Lunarequest/foxboard/#keyboard-layout.dxf

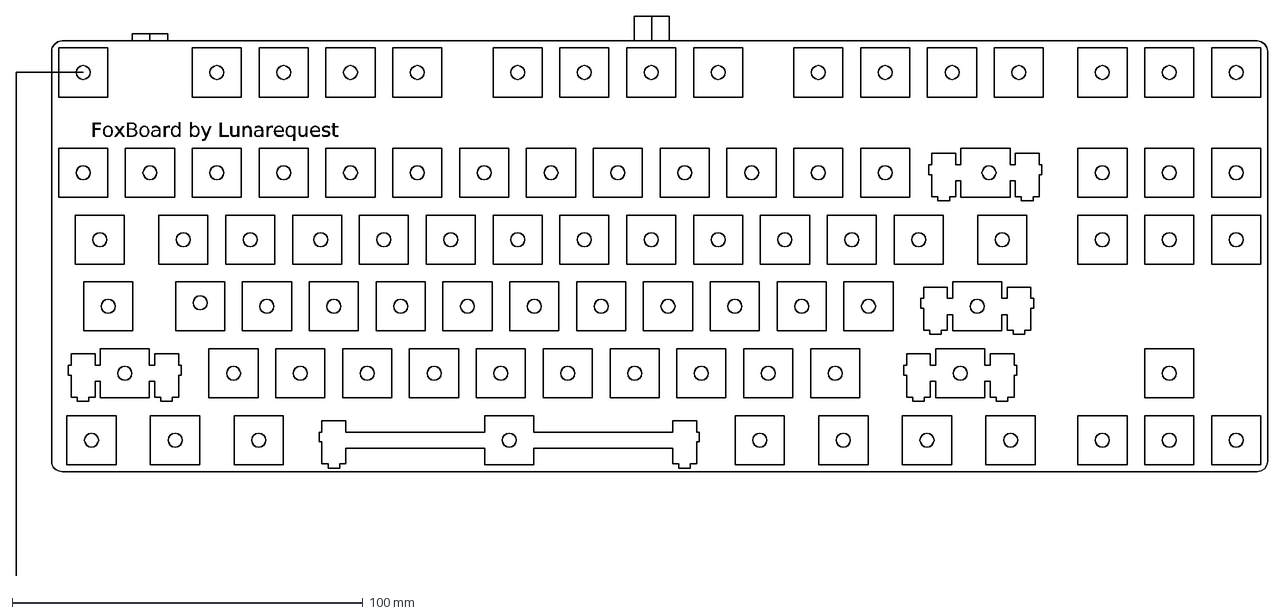
[picture p1: CAD file, 2024-01-16]
#keyboard-layout.dxf
FoxBoard by Lunarequest
