Lunarequest/foxboard/(list of files, cad)

Other CAD files:
keyboard-layout.dxf
