Lunarequest/foxboard/kicad/foxboard/foxboard.pdf

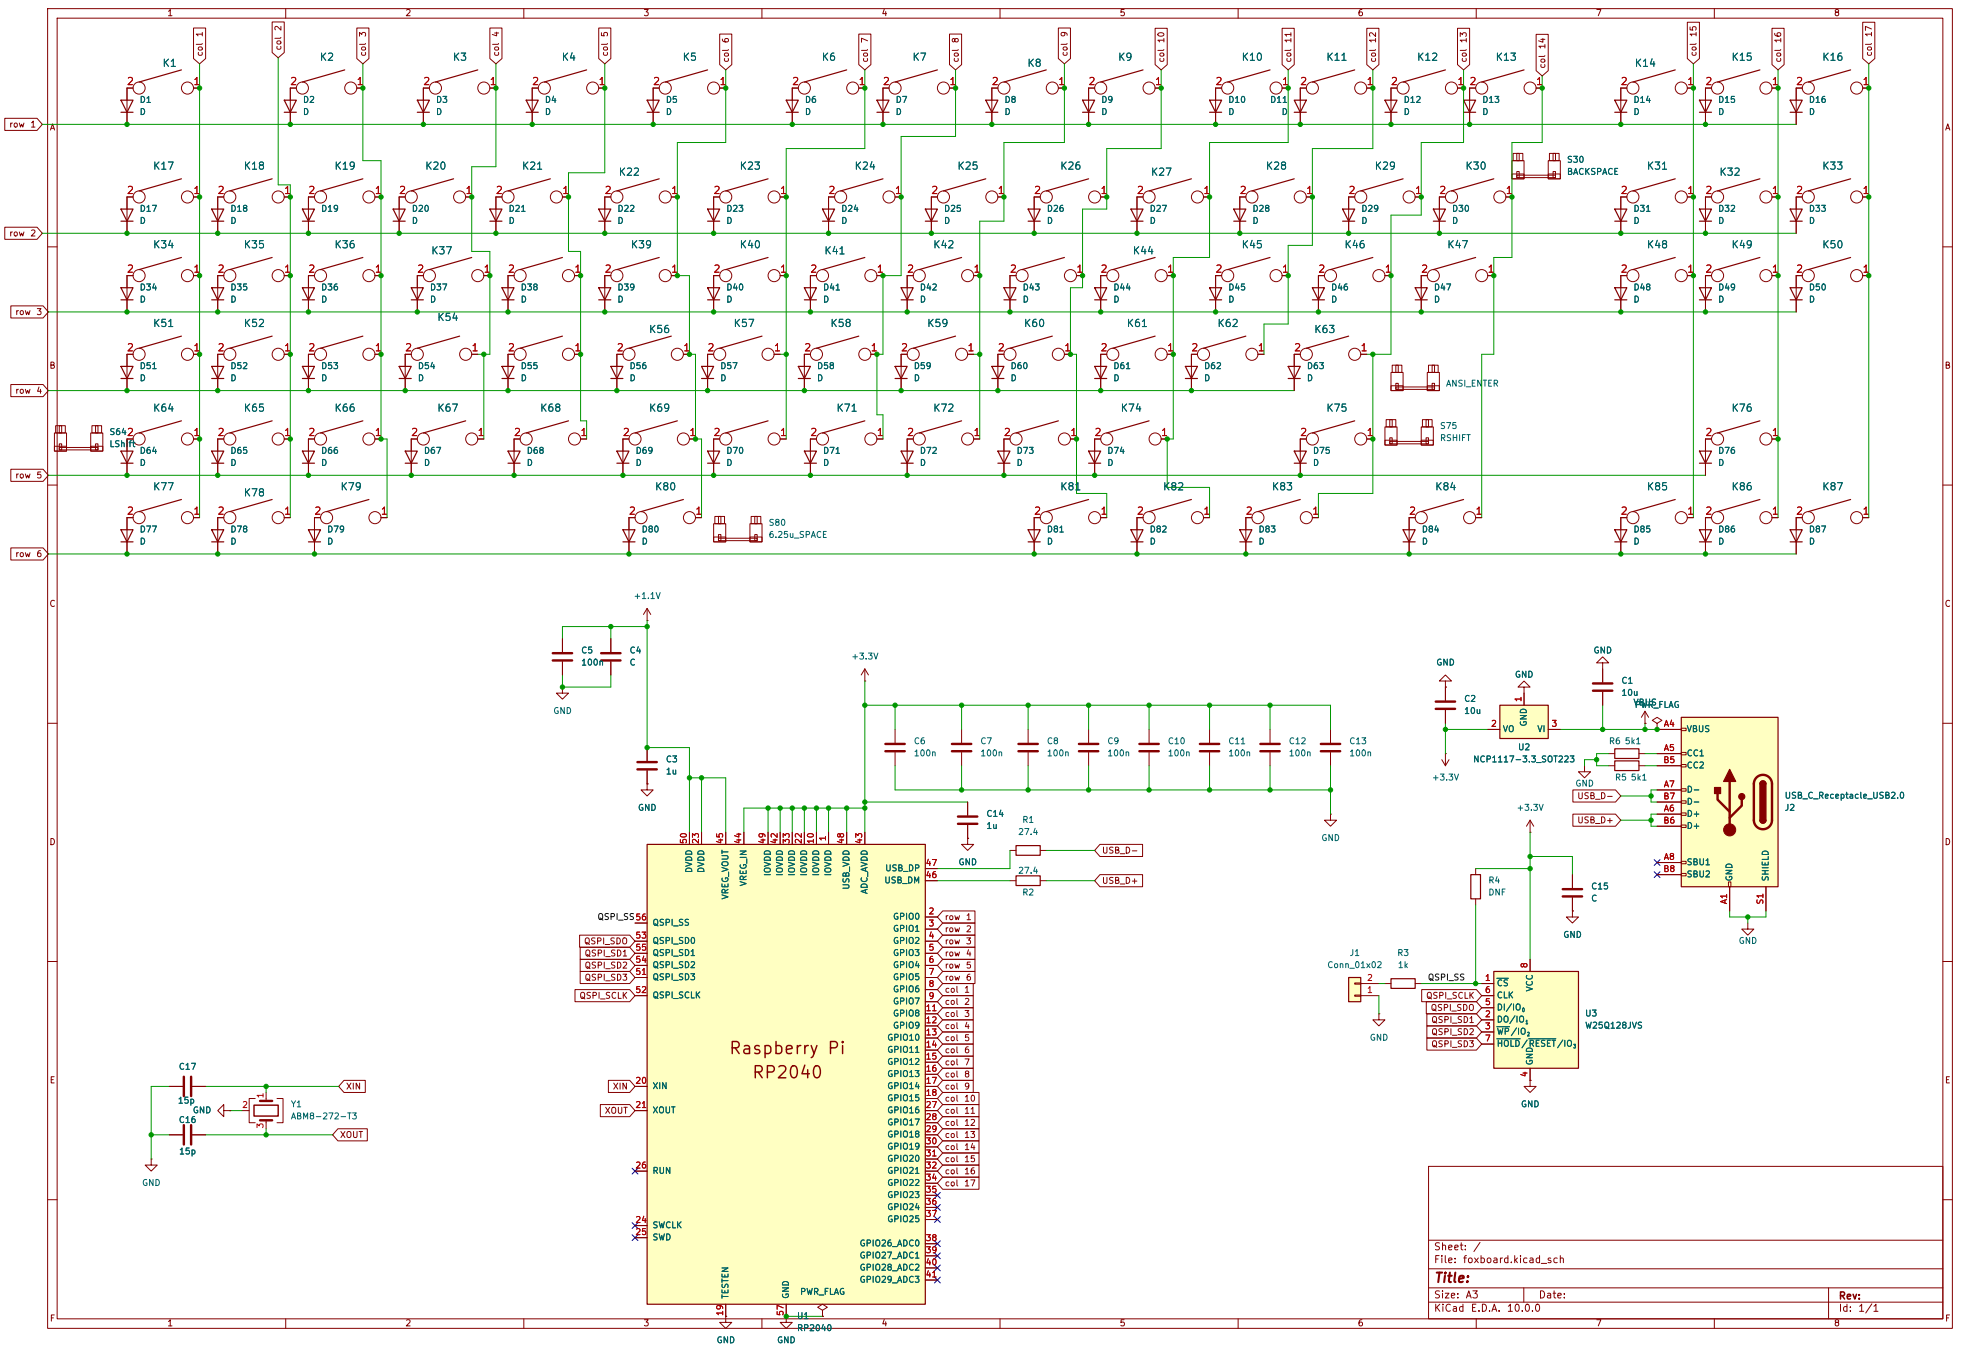
[picture p2: page 1]

4 DI/IO0 5 CLK 6 HOLD/RESET/IO3 7 VCC

Size: A3 | Rev: | F Date:
KiCad E.D.A. 10.0.0 | Id: 1/1
