Lunarequest/foxboard/kicad/foxboard/foxboard.kicad_pcb

## KiCad design kicad/foxboard/foxboard.kicad_pcb (2026-08-29)

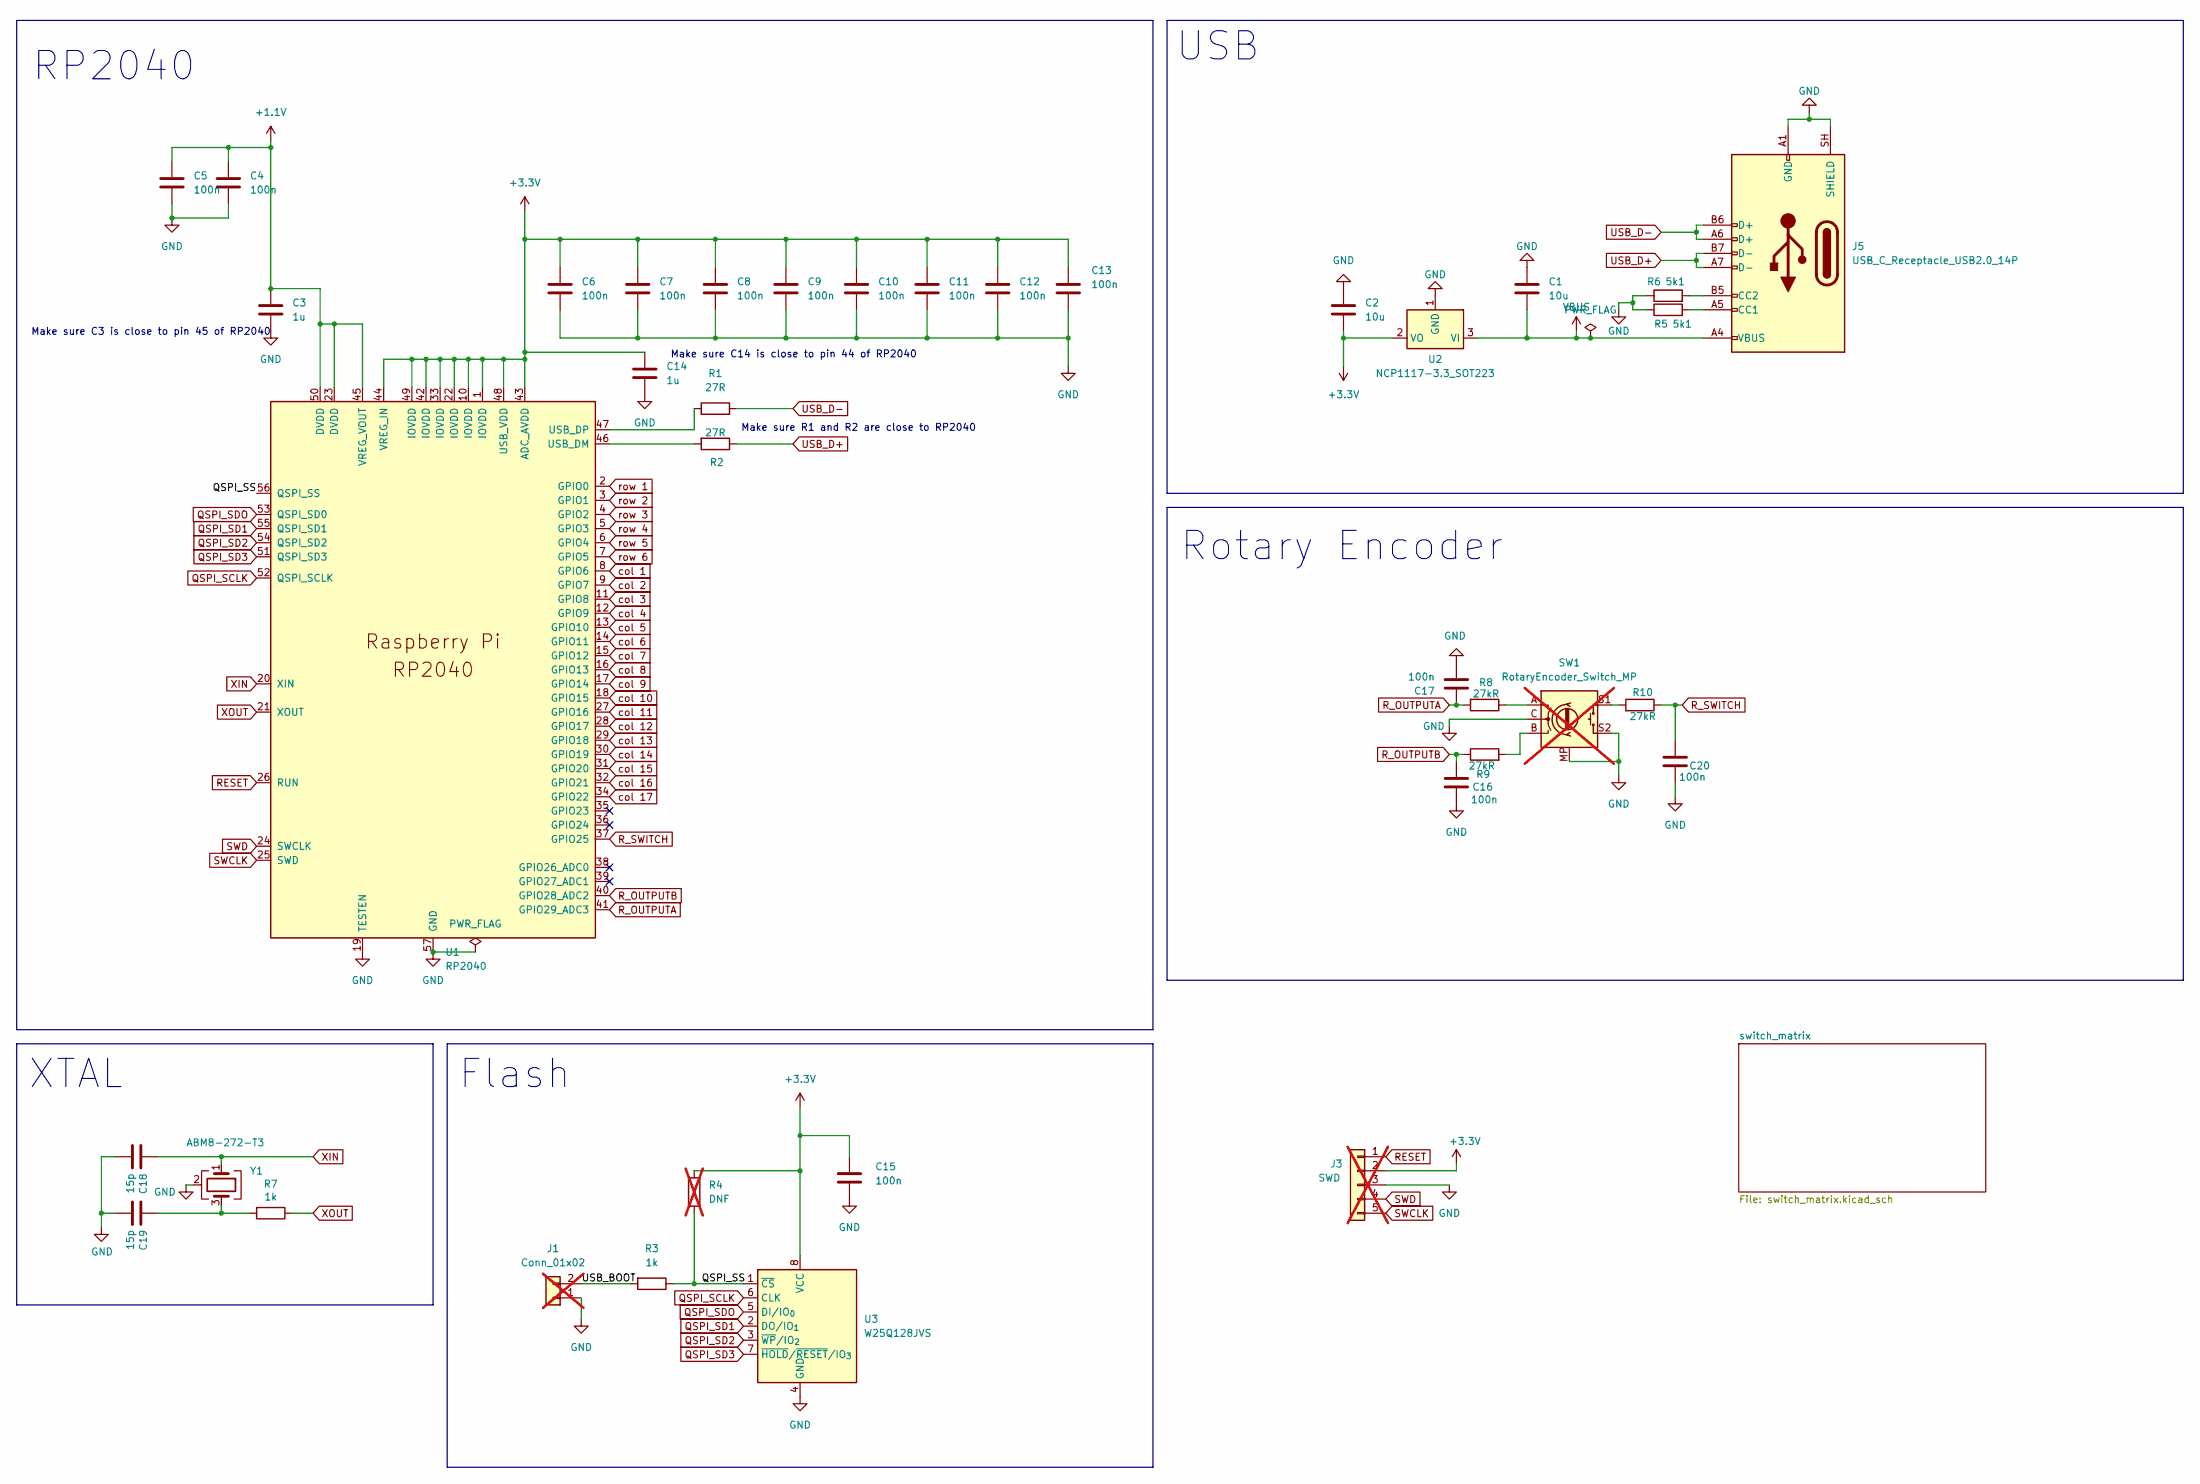
[picture p3: schematic foxboard.kicad_sch]

Parts:
C1, C2: 10u; C_0402_1005Metric_Pad0.74x0.62mm_HandSolder; MPN CL05A106MP5NUNC; LCSC C315248
C3, C14: 1u; C_0402_1005Metric_Pad0.74x0.62mm_HandSolder; MPN CL05A105KO5NNNC; LCSC C29266
C4, C5, C6, C7, C8, C9, C10, C11, C12, C13, C15, C16, C17, C20: 100n; C_0402_1005Metric_Pad0.74x0.62mm_HandSolder; MPN CL05B104KP5VPNC; LCSC C16193311
C18, C19: 15p; C_0402_1005Metric; MPN CL05C150JB5NNNC; LCSC C86285
J1: Conn_01x02; PinHeader_1x02_P2.54mm_Vertical; not fitted
J3: SWD; PinSocket_1x05_P2.54mm_Vertical; not fitted
J5: USB_C_Receptacle_USB2.0_14P; USB_C_Receptacle_HRO_TYPE-C-31-M-12; MPN TYPE-C-31-M-12; LCSC C165948
R1, R2: 27R; R_0402_1005Metric_Pad0.72x0.64mm_HandSolder; MPN 0402WGF1001TCE; LCSC C11702
R3, R7: 1k; R_0402_1005Metric_Pad0.72x0.64mm_HandSolder; MPN UNI-ROYAL TC0225B1001TCC; LCSC C2989674
R4: DNF; R_0402_1005Metric_Pad0.72x0.64mm_HandSolder; not fitted
R5, R6: 5k1; R_0402_1005Metric_Pad0.72x0.64mm_HandSolder; MPN 0402WGF5101TCE; LCSC C25905
R8, R9, R10: 27kR; R_0402_1005Metric_Pad0.72x0.64mm_HandSolder; MPN CRCW040227R0JNED
SW1: RotaryEncoder_Switch_MP; RotaryEncoder_Bourns_Horizontal_PEC12R-2x17F-Sxxxx; not fitted
U1: RP2040; RP2040-QFN-56; MPN RP2040; LCSC C2040
U2: NCP1117-3.3_SOT223; SOT-223-3_TabPin2; MPN NCP1117STAT3G; LCSC C20546
U3: W25Q128JVS; SOIC-8_5.3x5.3mm_P1.27mm; MPN W25Q128JVSIQ; LCSC C97521
Y1: ABM8-272-T3; Crystal_SMD_3225-4Pin_3.2x2.5mm; MPN XC32M4-12.000-F10NNFT; LCSC C2842186

Connections:
+1.1V: C3.1, C4.1, C5.1, U1.23 (DVDD), U1.45 (VREG_VOUT), U1.50 (DVDD)
+3.3V: C2.2, C6.1, C7.1, C8.1, C9.1, C10.1, C11.1, C12.1, C13.1, C14.1, C15.1, J3.2, R4.1, U1.1 (IOVDD), U1.10 (IOVDD), U1.22 (IOVDD), U1.33 (IOVDD), U1.42 (IOVDD), U1.43 (ADC_AVDD), U1.44 (VREG_IN), U1.48 (USB_VDD), U1.49 (IOVDD), U2.2 (VO), U3.8 (VCC)
/QSPI_SS: R3.1, R4.2, U1.56 (QSPI_SS), U3.1 (~CS)
/USB_BOOT: J1.2, R3.2
GND: C1.2, C2.1, C3.2, C4.2, C5.2, C6.2, C7.2, C8.2, C9.2, C10.2, C11.2, C12.2, C13.2, C14.2, C15.2, C16.2, C17.2, C18.2, C19.2, C20.2, J1.1, J3.3, J5.A1 (GND), J5.A12 (GND), J5.B1 (GND), J5.B12 (GND), J5.SH (SHIELD), R5.1, R6.1, SW1.C, SW1.MP, SW1.S2, U1.19 (TESTEN), U1.57 (GND), U2.1 (GND), U3.4 (GND), Y1.2 (G), Y1.4 (G)
unnamed: C19.1, R7.2, Y1.3
unnamed: J5.A5 (CC1), R5.2
unnamed: J5.B5 (CC2), R6.2
unnamed: R8.1, SW1.A
unnamed: R9.2, SW1.B
unnamed: R10.2, SW1.S1
unnamed: R2.2, U1.46 (USB_DM)
unnamed: R1.1, U1.47 (USB_DP)
QSPI_SCLK: U1.52 (QSPI_SCLK), U3.6 (CLK)
QSPI_SD1: U1.55 (QSPI_SD1), U3.2 (DO/IO_{1})
QSPI_SD2: U1.54 (QSPI_SD2), U3.3 (~WP/IO_{2})
QSPI_SD3: U1.51 (QSPI_SD3), U3.7 (~HOLD/~RESET/IO_{3})
QSPI_SDO: U1.53 (QSPI_SD0), U3.5 (DI/IO_{0})
RESET: J3.1, U1.26 (RUN)
R_OUTPUTA: C17.1, R8.2, U1.41 (GPIO29_ADC3)
R_OUTPUTB: C16.1, R9.1, U1.40 (GPIO28_ADC2)
R_SWITCH: C20.1, R10.1, U1.37 (GPIO25)
SWCLK: J3.5, U1.25 (SWD)
SWD: J3.4, U1.24 (SWCLK)
USB_D+: J5.A7 (D-), J5.B7 (D-), R2.1
USB_D-: J5.A6 (D+), J5.B6 (D+), R1.2
VBUS: C1.1, J5.A4 (VBUS), J5.A9 (VBUS), J5.B4 (VBUS), J5.B9 (VBUS), U2.3 (VI)
XIN: C18.1, U1.20 (XIN), Y1.1
XOUT: R7.1, U1.21 (XOUT)
col 1: U1.8 (GPIO6); also elsewhere on the board
col 2: U1.9 (GPIO7); also elsewhere on the board
col 3: U1.11 (GPIO8); also elsewhere on the board
col 4: U1.12 (GPIO9); also elsewhere on the board
col 5: U1.13 (GPIO10); also elsewhere on the board
col 6: U1.14 (GPIO11); also elsewhere on the board
col 7: U1.15 (GPIO12); also elsewhere on the board
col 8: U1.16 (GPIO13); also elsewhere on the board
col 9: U1.17 (GPIO14); also elsewhere on the board
col 10: U1.18 (GPIO15); also elsewhere on the board
col 11: U1.27 (GPIO16); also elsewhere on the board
col 12: U1.28 (GPIO17); also elsewhere on the board
col 13: U1.29 (GPIO18); also elsewhere on the board
col 14: U1.30 (GPIO19); also elsewhere on the board
col 15: U1.31 (GPIO20); also elsewhere on the board
col 16: U1.32 (GPIO21); also elsewhere on the board
col 17: U1.34 (GPIO22); also elsewhere on the board
row 1: U1.2 (GPIO0); also elsewhere on the board
row 2: U1.3 (GPIO1); also elsewhere on the board
row 3: U1.4 (GPIO2); also elsewhere on the board
row 4: U1.5 (GPIO3); also elsewhere on the board
row 5: U1.6 (GPIO4); also elsewhere on the board
row 6: U1.7 (GPIO5); also elsewhere on the board

Notes on the sheet:
USB
RP2040
Make sure C14 is close to pin 44 of RP2040
XTAL
Rotary Encoder
Make sure C3 is close to pin 45 of RP2040
Make sure R1 and R2 are close to RP2040
Flash

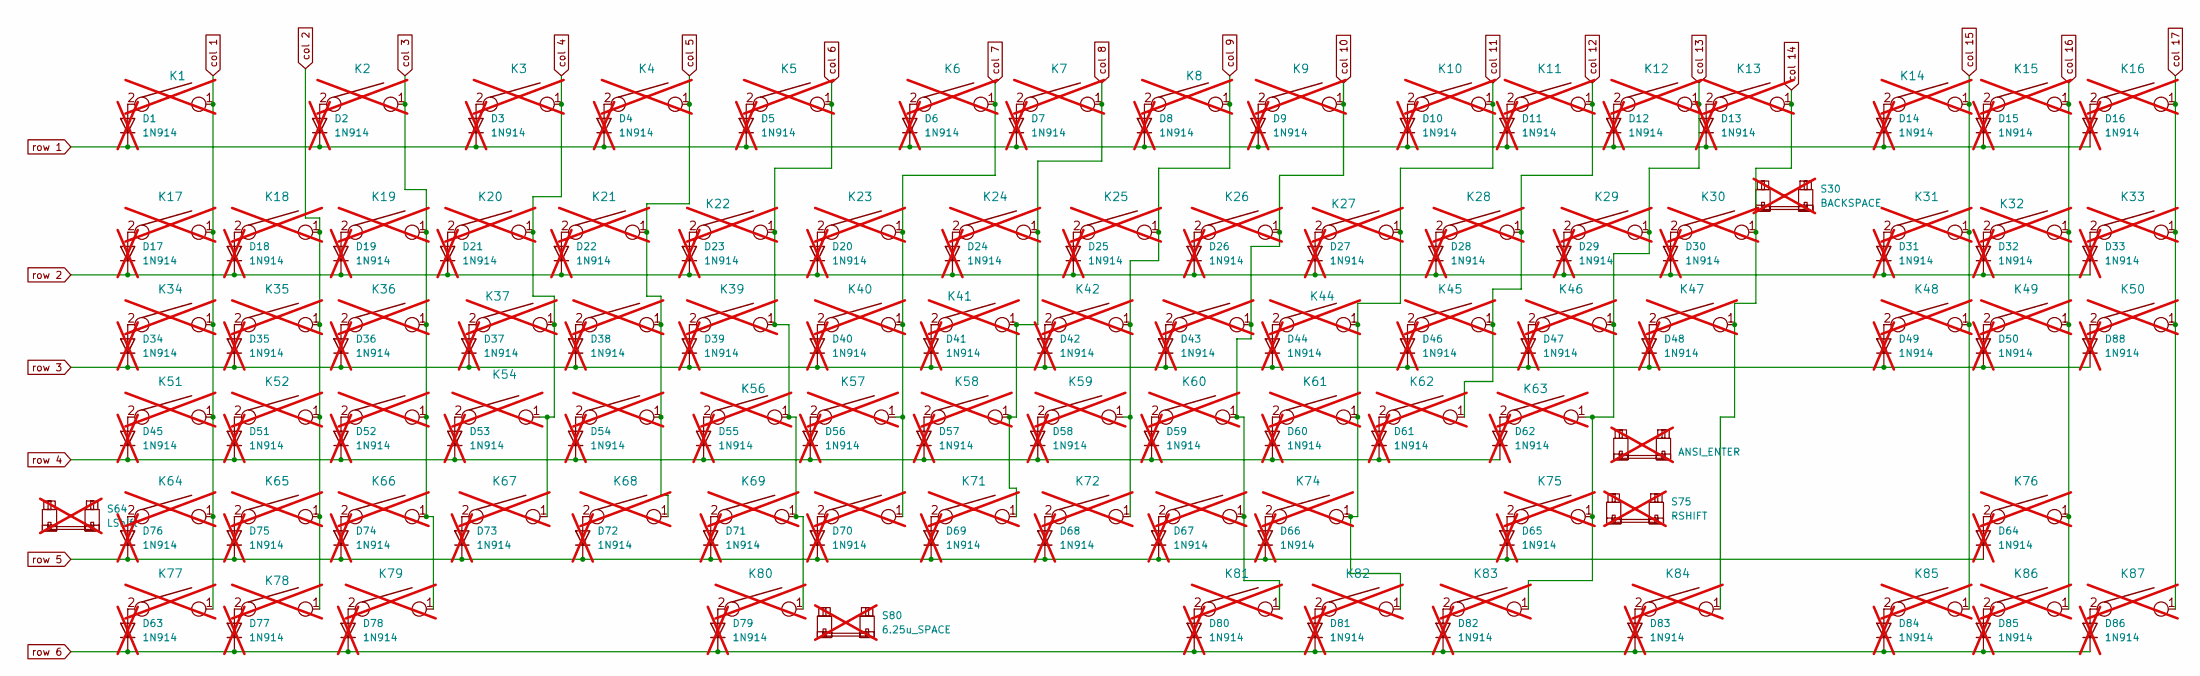
[picture p4: schematic switch_matrix.kicad_sch]

Parts:
D1, D2, D3, D4, D5, D6, D7, D8, D9, D10, D11, D12, D13, D14, D15, D16, D17, D18, D19, D20, D21, D22, D23, D24, D25, D26, D27, D28, D29, D30, D31, D32, D33, D34, D35, D36, D37, D38, D39, D40, D41, D42, D43, D44, D45, D46, D47, D48, D49, D50, D51, D52, D53, D54, D55, D56, D57, D58, D59, D60, D61, D62, D63, D64, D65, D66, D67, D68, D69, D70, D71, D72, D73, D74, D75, D76, D77, D78, D79, D80, D81, D82, D83, D84, D85, D86, D88: 1N914; D_DO-35_SOD27_P7.62mm_Horizontal; MPN 1N914TAP; LCSC C17693320; not fitted
K1, K2, K3, K4, K5, K6, K7, K8, K10, K11, K12, K13, K14, K16, K17, K18, K19, K20, K21, K22, K23, K24, K25, K26, K27, K28, K29, K30, K31, K32, K33, K35, K36, K37, K38, K39, K40, K41, K42, K43, K44, K45, K46, K48, K49, K50, K52, K53, K54, K55, K56, K57, K58, K59, K60, K61, K62, K63, K64, K65, K66, K67, K68, K69, K70, K71, K72, K73, K74, K75, K76, K80, K84, K85, K86, K87: KEYSW; SW_MX_1u; not fitted
K9, K15, K77, K78, K79, K81, K82, K83: KEYSW; SW_MX_1.25u; not fitted
K34, K47: KEYSW; SW_MX_1.5u; not fitted
K51: KEYSW; SW_MX_1.75u; not fitted
S30: BACKSPACE; STAB_MX_2u; not fitted
S63: ANSI_ENTER; STAB_MX_2.25u; not fitted
S64: LShift; STAB_MX_2.25u; not fitted
S75: RSHIFT; STAB_MX_P_2.75u; not fitted
S80: 6.25u_SPACE; STAB_MX_P_6.25u; not fitted

Connections:
unnamed: D1.2 (A), K1.2
unnamed: D2.2 (A), K2.2
unnamed: D3.2 (A), K3.2
unnamed: D4.2 (A), K4.2
unnamed: D5.2 (A), K5.2
unnamed: D6.2 (A), K6.2
unnamed: D7.2 (A), K7.2
unnamed: D8.2 (A), K8.2
unnamed: D9.2 (A), K9.2
unnamed: D10.2 (A), K10.2
unnamed: D11.2 (A), K11.2
unnamed: D12.2 (A), K12.2
unnamed: D13.2 (A), K13.2
unnamed: D14.2 (A), K14.2
unnamed: D15.2 (A), K15.2
unnamed: D16.2 (A), K16.2
unnamed: D17.2 (A), K17.2
unnamed: D18.2 (A), K18.2
unnamed: D19.2 (A), K19.2
unnamed: D20.2 (A), K23.2
unnamed: D21.2 (A), K20.2
unnamed: D22.2 (A), K21.2
unnamed: D23.2 (A), K22.2
unnamed: D24.2 (A), K24.2
unnamed: D25.2 (A), K25.2
unnamed: D26.2 (A), K26.2
unnamed: D27.2 (A), K27.2
unnamed: D28.2 (A), K28.2
unnamed: D29.2 (A), K29.2
unnamed: D30.2 (A), K30.2
unnamed: D31.2 (A), K31.2
unnamed: D32.2 (A), K32.2
unnamed: D33.2 (A), K33.2
unnamed: D34.2 (A), K34.2
unnamed: D35.2 (A), K35.2
unnamed: D36.2 (A), K36.2
unnamed: D37.2 (A), K37.2
unnamed: D38.2 (A), K38.2
unnamed: D39.2 (A), K39.2
unnamed: D40.2 (A), K40.2
unnamed: D41.2 (A), K41.2
unnamed: D42.2 (A), K42.2
unnamed: D43.2 (A), K43.2
unnamed: D44.2 (A), K44.2
unnamed: D45.2 (A), K51.2
unnamed: D46.2 (A), K45.2
unnamed: D47.2 (A), K46.2
unnamed: D48.2 (A), K47.2
unnamed: D49.2 (A), K48.2
unnamed: D50.2 (A), K49.2
unnamed: D51.2 (A), K52.2
unnamed: D52.2 (A), K53.2
unnamed: D53.2 (A), K54.2
unnamed: D54.2 (A), K55.2
unnamed: D55.2 (A), K56.2
unnamed: D56.2 (A), K57.2
unnamed: D57.2 (A), K58.2
unnamed: D58.2 (A), K59.2
unnamed: D59.2 (A), K60.2
unnamed: D60.2 (A), K61.2
unnamed: D61.2 (A), K62.2
unnamed: D62.2 (A), K63.2
unnamed: D63.2 (A), K77.2
unnamed: D64.2 (A), K76.2
unnamed: D65.2 (A), K75.2
unnamed: D66.2 (A), K74.2
unnamed: D67.2 (A), K73.2
unnamed: D68.2 (A), K72.2
unnamed: D69.2 (A), K71.2
unnamed: D70.2 (A), K70.2
unnamed: D71.2 (A), K69.2
unnamed: D72.2 (A), K68.2
unnamed: D73.2 (A), K67.2
unnamed: D74.2 (A), K66.2
unnamed: D75.2 (A), K65.2
unnamed: D76.2 (A), K64.2
unnamed: D77.2 (A), K78.2
unnamed: D78.2 (A), K79.2
unnamed: D79.2 (A), K80.2
unnamed: D80.2 (A), K81.2
unnamed: D81.2 (A), K82.2
unnamed: D82.2 (A), K83.2
unnamed: D83.2 (A), K84.2
unnamed: D84.2 (A), K85.2
unnamed: D85.2 (A), K86.2
unnamed: D86.2 (A), K87.2
unnamed: D88.2 (A), K50.2
col 1: K1.1, K17.1, K34.1, K51.1, K64.1, K77.1; also elsewhere on the board
col 2: K18.1, K35.1, K52.1, K65.1, K78.1; also elsewhere on the board
col 3: K2.1, K19.1, K36.1, K53.1, K66.1, K79.1; also elsewhere on the board
col 4: K3.1, K20.1, K37.1, K54.1, K67.1; also elsewhere on the board
col 5: K4.1, K21.1, K38.1, K55.1, K68.1; also elsewhere on the board
col 6: K5.1, K22.1, K39.1, K56.1, K69.1, K80.1; also elsewhere on the board
col 7: K6.1, K23.1, K40.1, K57.1, K70.1; also elsewhere on the board
col 8: K7.1, K24.1, K41.1, K58.1, K71.1; also elsewhere on the board
col 9: K8.1, K25.1, K42.1, K59.1, K72.1; also elsewhere on the board
col 10: K9.1, K26.1, K43.1, K60.1, K73.1, K81.1; also elsewhere on the board
col 11: K10.1, K27.1, K44.1, K61.1, K74.1, K82.1; also elsewhere on the board
col 12: K11.1, K28.1, K45.1, K62.1; also elsewhere on the board
col 13: K12.1, K29.1, K46.1, K63.1, K75.1, K83.1; also elsewhere on the board
col 14: K13.1, K30.1, K47.1, K84.1; also elsewhere on the board
col 15: K14.1, K31.1, K48.1, K85.1; also elsewhere on the board
col 16: K15.1, K32.1, K49.1, K76.1, K86.1; also elsewhere on the board
col 17: K16.1, K33.1, K50.1, K87.1; also elsewhere on the board
row 1: D1.1 (K), D2.1 (K), D3.1 (K), D4.1 (K), D5.1 (K), D6.1 (K), D7.1 (K), D8.1 (K), D9.1 (K), D10.1 (K), D11.1 (K), D12.1 (K), D13.1 (K), D14.1 (K), D15.1 (K), D16.1 (K); also elsewhere on the board
row 2: D17.1 (K), D18.1 (K), D19.1 (K), D20.1 (K), D21.1 (K), D22.1 (K), D23.1 (K), D24.1 (K), D25.1 (K), D26.1 (K), D27.1 (K), D28.1 (K), D29.1 (K), D30.1 (K), D31.1 (K), D32.1 (K), D33.1 (K); also elsewhere on the board
row 3: D34.1 (K), D35.1 (K), D36.1 (K), D37.1 (K), D38.1 (K), D39.1 (K), D40.1 (K), D41.1 (K), D42.1 (K), D43.1 (K), D44.1 (K), D46.1 (K), D47.1 (K), D48.1 (K), D49.1 (K), D50.1 (K), D88.1 (K); also elsewhere on the board
row 4: D45.1 (K), D51.1 (K), D52.1 (K), D53.1 (K), D54.1 (K), D55.1 (K), D56.1 (K), D57.1 (K), D58.1 (K), D59.1 (K), D60.1 (K), D61.1 (K), D62.1 (K); also elsewhere on the board
row 5: D64.1 (K), D65.1 (K), D66.1 (K), D67.1 (K), D68.1 (K), D69.1 (K), D70.1 (K), D71.1 (K), D72.1 (K), D73.1 (K), D74.1 (K), D75.1 (K), D76.1 (K); also elsewhere on the board
row 6: D63.1 (K), D77.1 (K), D78.1 (K), D79.1 (K), D80.1 (K), D81.1 (K), D82.1 (K), D83.1 (K), D84.1 (K), D85.1 (K), D86.1 (K); also elsewhere on the board

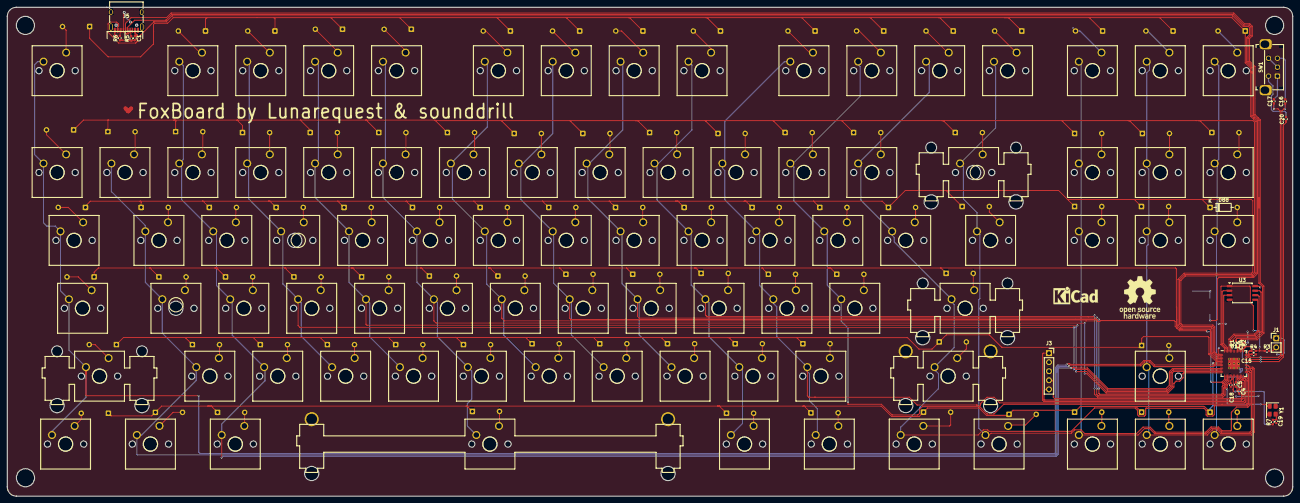
[picture p5: board foxboard.kicad_pcb from above]

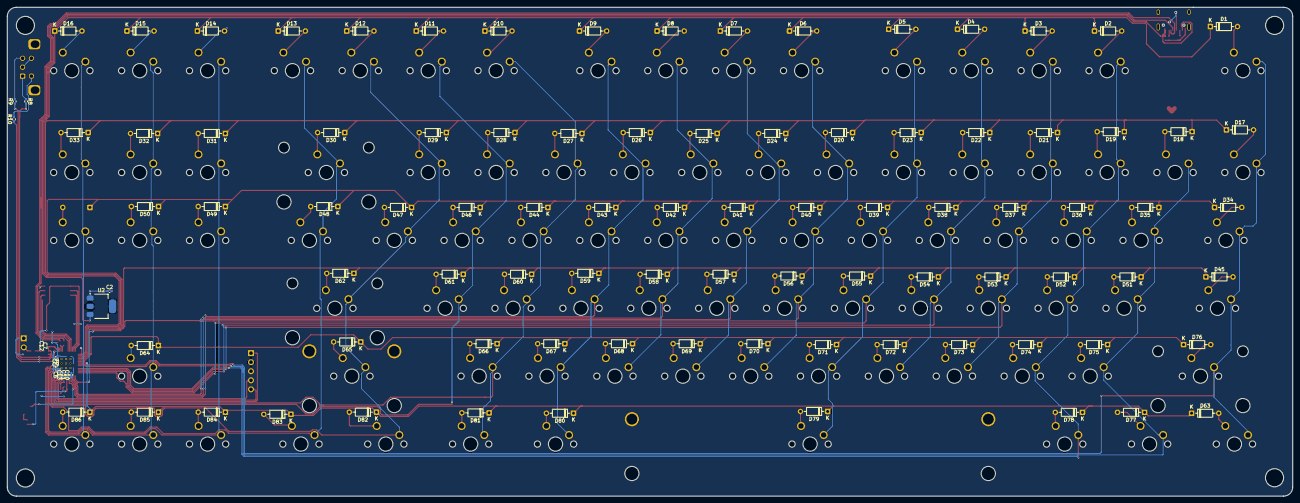
[picture p6: board foxboard.kicad_pcb from below]

Board: 2 copper layers, 360.7 x 137.2 mm, 217 parts (99 on the bottom side), 139 nets.
