Lunarequest/foxboard/(commit log)

2023-06-28 wip foxboard
    [foxboard.kicad_pcb, foxboard.kicad_sch, keyboard-layout.dxf]
2024-01-16 move teensy and stuff
    [foxboard.kicad_pcb]
2024-01-16 add keyswitch and change some footprints
    [foxboard.kicad_pcb]
2024-01-16 update layout
    [foxboard.kicad_pcb, foxboard.kicad_sch]
2024-01-16 update some footprints and move most diodes into place
    [foxboard.kicad_pcb, foxboard.kicad_sch]
2024-01-16 update footprints
    [foxboard.kicad_pcb]
2024-01-16 finish layout
    [foxboard.kicad_pcb]
2024-01-17 move all resitors, caps and diodes to the back of the pcb
    [foxboard.kicad_pcb, foxboard.kicad_sch]
2024-01-17 update footprint to be 1.5u
    [foxboard.kicad_pcb]
2024-01-17 move a keyswitch
    [foxboard.kicad_pcb]
2024-01-17 flip diode that was missing
    [foxboard.kicad_pcb]
2024-01-17 reimported keyboard-layout.dxf as Foreground Silk Layer
    [foxboard.kicad_pcb]
2024-01-18 add rows
    [foxboard.csv, foxboard.kicad_pcb, foxboard.kicad_sch]
2024-01-19 add few rows update eeschema
    [foxboard.kicad_pcb, foxboard.kicad_sch]
2024-01-19 add few cols & update eeschema
    [foxboard.kicad_pcb, foxboard.kicad_sch]
2024-01-19 add finish cols and usbc & update eeschema
    [foxboard.kicad_pcb, foxboard.kicad_sch]
2024-01-19 Cleaned up the USB-C connector layout and made use of power symbols for schematic clarity
    [foxboard.kicad_sch]
2024-01-19 Made the footprint libraries project-relative
2024-01-19 move teensy a little back
    [foxboard.kicad_pcb]
2024-01-20 hook up resistor to ground
    [foxboard.kicad_pcb]
2024-01-21 switch to better layout
    [foxboard.kicad_pcb, foxboard.kicad_sch]
2024-01-21 use usbc 2.0 recepticale
    [foxboard.kicad_pcb, foxboard.kicad_sch]
2024-01-21 add fill
    [foxboard.kicad_pcb]
2024-01-24 add footprint for SOD882D & RESC168X55N
    [foxboard.kicad_pcb, foxboard.kicad_sch]
2024-06-09 update deps
    [foxboard.kicad_pcb, foxboard.kicad_sch]
2024-06-11 make sure all connections are connected, change resistor package to 0805
    [foxboard.kicad_pcb, foxboard.kicad_sch]
2026-05-15 wip v2
    [foxboard.kicad_sch]
2026-05-15 fix most violations
    [foxboard.kicad_sch]
2026-05-16 add powerflags
    [foxboard.kicad_sch]
2026-05-16 fix all warnings
    [foxboard.kicad_sch]
2026-05-16 assigned footprints
    [foxboard.kicad_sch]
2026-05-18 finish matrix
    [foxboard.kicad_pcb, foxboard.kicad_sch]
2026-05-24 Finish routing pcb
    [foxboard.kicad_pcb]
2026-05-27 fabrication outputs
    [bom.csv, designators.csv, foxboard.csv, foxboard.kicad_pcb, foxboard.kicad_sch, positions.csv]
2026-05-28 Include rotary encoder and cleanup some wires
    [foxboard.kicad_pcb, foxboard.kicad_sch]
2026-05-28 Close kicad(cleans up some lock files)
2026-06-05 chore: moved the switch matrix into another sheet
    [foxboard.kicad_sch, switch_matrix.kicad_sch]
2026-06-05 chore: neatly ordered sections of schematic into named blocks
    [foxboard.kicad_sch]
2026-06-05 chore: updated gitignore with files not needed in git
    [foxboard.kicad_sch]
